benthacher/pedal/pedal.kicad_pcb

## KiCad design pedal.kicad_pcb (2026-10-10)

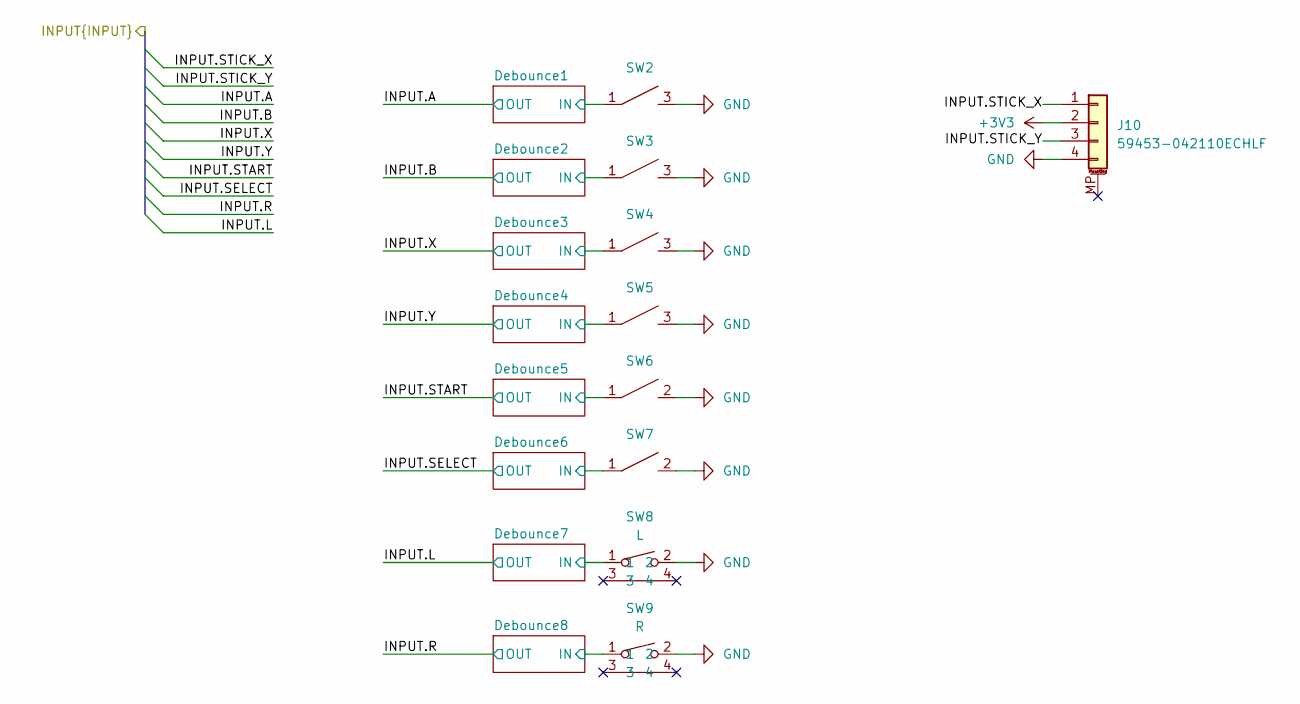
[picture p1: schematic input.kicad_sch]

Parts:
J10: 59453-042110ECHLF; AMPHENOL_59453-042110ECHLF; LCSC C3169529
SW2: A; SW-SMD_4P-L4.5-W4.5-P3.50-LS4.8; MPN TL3315NF100Q; LCSC Part C173769
SW3: B; SW-SMD_4P-L4.5-W4.5-P3.50-LS4.8; MPN TL3315NF100Q; LCSC Part C173769
SW4: X; SW-SMD_4P-L4.5-W4.5-P3.50-LS4.8; MPN TL3315NF100Q; LCSC Part C173769
SW5: Y; SW-SMD_4P-L4.5-W4.5-P3.50-LS4.8; MPN TL3315NF100Q; LCSC Part C173769
SW6: START; SW-SMD_L3.9-W3.0-P4.45; MPN TS-1088-AR02016; LCSC Part C720477
SW7: SELECT; SW-SMD_L3.9-W3.0-P4.45; MPN TS-1088-AR02016; LCSC Part C720477
SW8: L; SW-SMD_L4.7-W3.5-P3.35-EH; MPN TS-24CA-S26; LCSC Part C42420265
SW9: R; SW-SMD_L4.7-W3.5-P3.35-EH; MPN TS-24CA-S26; LCSC Part C42420265

Connections:
+3V3: J10.2; also elsewhere on the board
/Input/Debounce1/IN: SW2.1, SW2.2; also elsewhere on the board
/Input/Debounce2/IN: SW3.1, SW3.2; also elsewhere on the board
/Input/Debounce3/IN: SW4.1, SW4.2; also elsewhere on the board
/Input/Debounce4/IN: SW5.1, SW5.2; also elsewhere on the board
/Input/Debounce5/IN: SW6.1; also elsewhere on the board
/Input/Debounce6/IN: SW7.1; also elsewhere on the board
/Input/Debounce7/IN: SW8.1; also elsewhere on the board
/Input/Debounce8/IN: SW9.1; also elsewhere on the board
/Input/INPUT.STICK_X: J10.1; also elsewhere on the board
/Input/INPUT.STICK_Y: J10.3; also elsewhere on the board
GND: J10.4, SW2.3, SW2.4, SW3.3, SW3.4, SW4.3, SW4.4, SW5.3, SW5.4, SW6.2, SW7.2, SW8.2, SW9.2; also elsewhere on the board

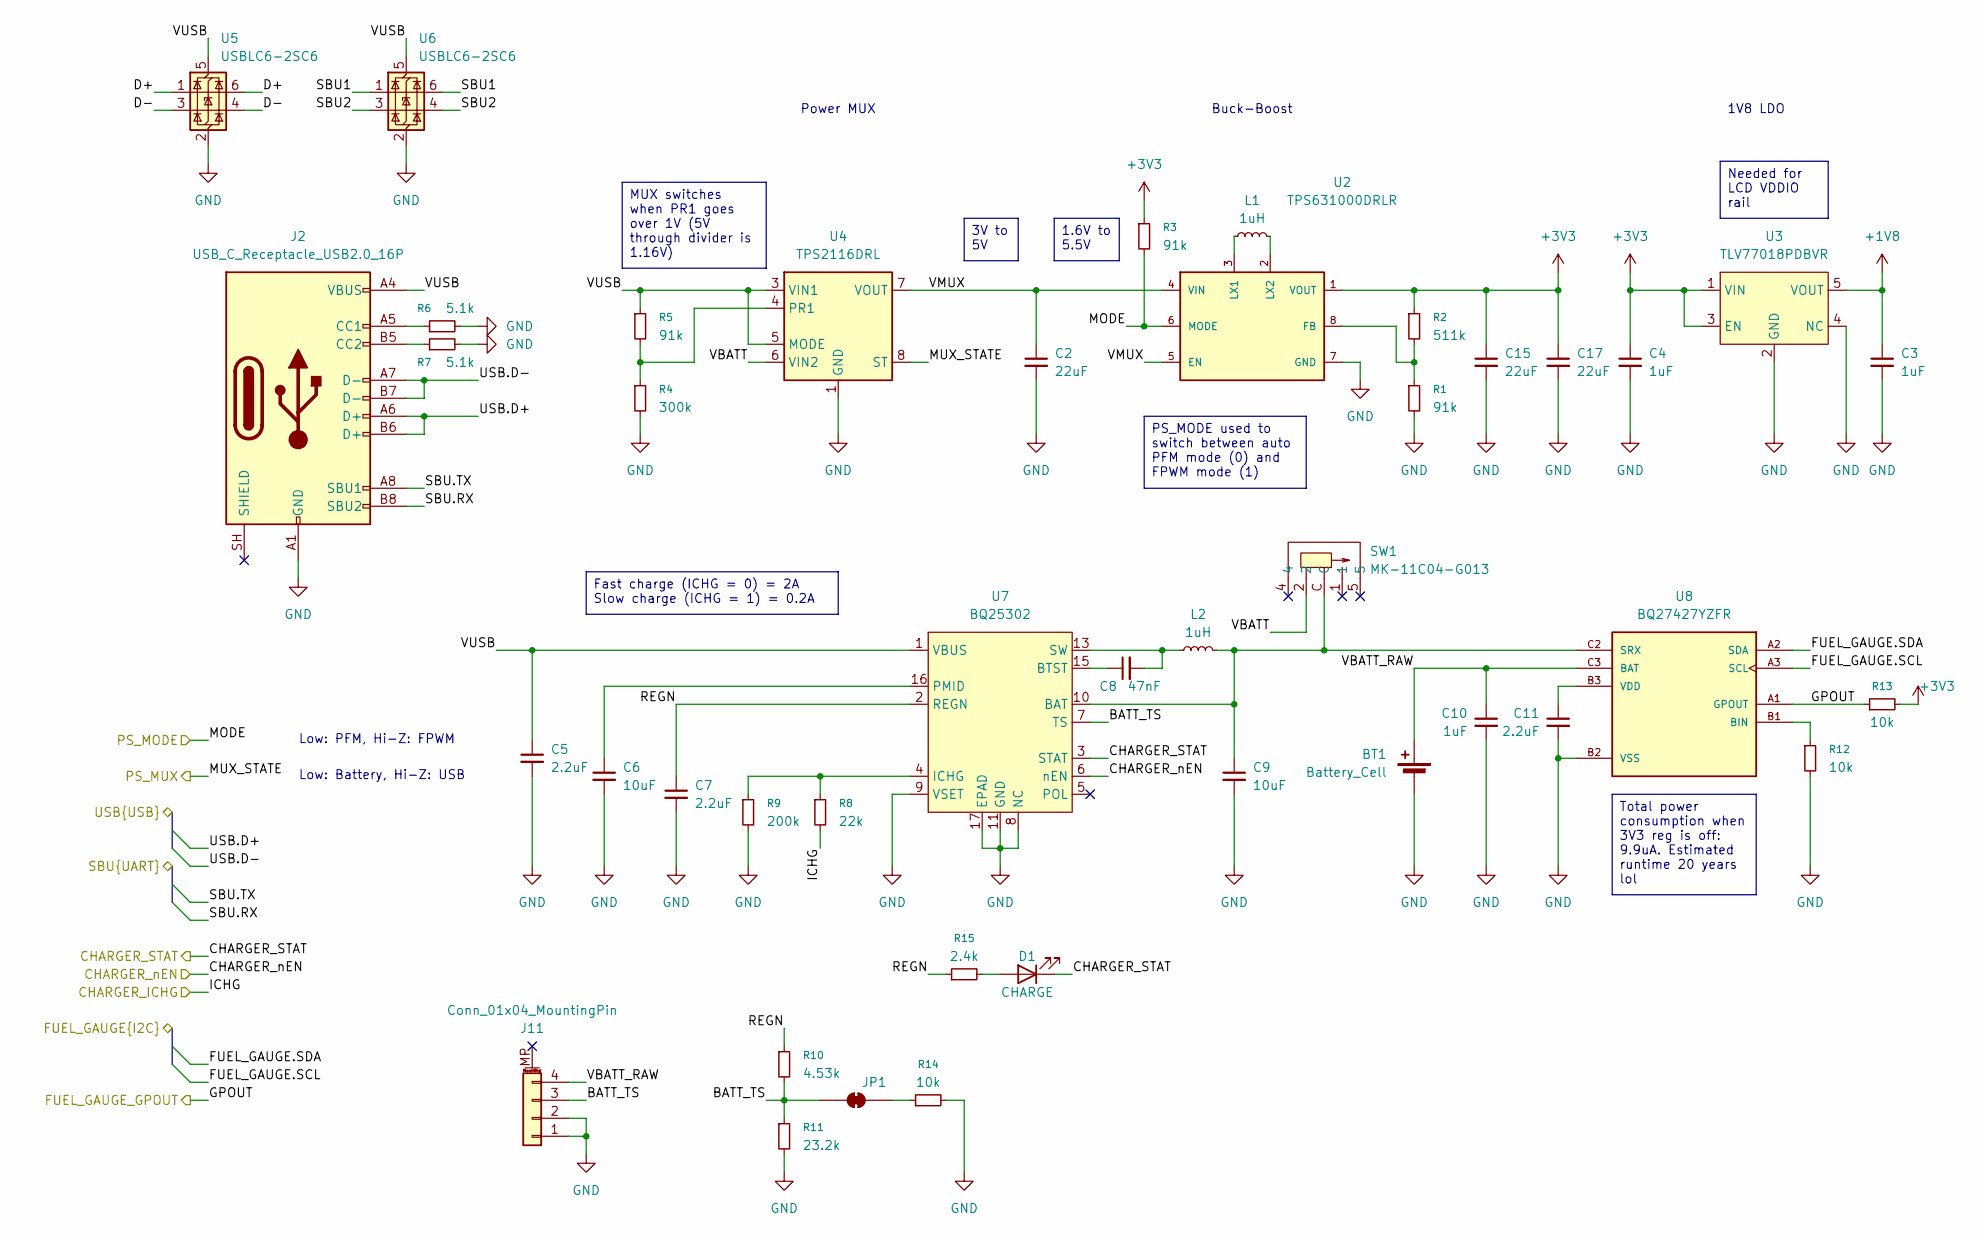
[picture p2: schematic power_path.kicad_sch]

Parts:
BT1: Battery_Cell
C2, C15, C17: 22uF; C_0805_2012Metric; Voltage 25V; LCSC C45783
C3: 1uF; C_0402_1005Metric; LCSC C52923
C4, C10: 1uF; C_0402_1005Metric; voltage 25; LCSC C52923
C5, C7, C11: 2.2uF; C_0603_1608Metric; Voltage 16; LCSC C23630
C6, C9: 10uF; C_0603_1608Metric; Voltage 25; LCSC C96446
C8: 47nF; C_0603_1608Metric; Voltage 50; LCSC C1622
D1: CHARGE; LED_0402_1005Metric; LCSC C5123495
J2: USB_C_Receptacle_USB2.0_16P; USB_C_Receptacle_HRO_TYPE-C-31-M-12; LCSC C165948
J11: Conn_01x04_MountingPin; CONN-SMD_4P-P1.00_2121340004
JP1: SolderJumper-2_P1.3mm_Bridged2Bar_RoundedPad1.0x1.5mm
L1, L2: 1uH; L_1008_2520Metric; LCSC C882955
R1, R3, R5: 91k; R_0402_1005Metric; LCSC C327323
R2: 511k; R_0402_1005Metric; LCSC C64042
R4: 300k; R_0402_1005Metric; LCSC C25774
R6, R7: 5.1k; R_0402_1005Metric; LCSC C25905
R8: 22k; R_0402_1005Metric; LCSC C25768
R9: 200k; R_0402_1005Metric; LCSC C25764
R10: 4.53k; R_0402_1005Metric; LCSC C79537
R11: 23.2k; R_0402_1005Metric; LCSC C25873
R12, R13, R14: 10k; R_0402_1005Metric; LCSC C25744
R15: 2.4k; R_0402_1005Metric; LCSC C25882
SW1: MK-11C04-G013; SW-SMD_MK-11C04-G013; MPN MK-11C04-G013; LCSC Part C778185
U2: TPS631000DRLR; SOT50P160X60-8N; PARTREV B; DigiKey_Part_Number 296-TPS631000DRLRCT-ND
U3: TLV77018PDBVR; SOT-23-5
U4: TPS2116DRL; SOT-583-8
U5, U6: USBLC6-2SC6; SOT-23-6; LCSC C5180249
U7: BQ25302; WQFN-16-1EP_3x3mm_P0.5mm_EP1.68x1.68mm_ThermalVias; LCSC C2761617
U8: BQ27427YZFR; IC_BQ27427YZFR; PARTREV December 2022; DigiKey_Part_Number 296-BQ27427YZFRCT-ND

Connections:
+1V8: C3.1, U3.5 (VOUT); also elsewhere on the board
+3V3: C4.1, C15.1, C17.1, R2.1, R3.1, R13.2, U2.1 (VOUT), U3.1 (VIN), U3.3 (EN); also elsewhere on the board
/Power path/BATT_TS: J11.3, JP1.1 (A), R10.2, R11.1, U7.7 (TS)
/Power path/CHARGER_STAT: D1.1 (K), U7.3 (STAT); also elsewhere on the board
/Power path/CHARGER_nEN: U7.6 (nEN); also elsewhere on the board
/Power path/D+: U5.1 (I/O1), U5.6 (I/O1)
/Power path/D-: U5.3 (I/O2), U5.4 (I/O2)
/Power path/FUEL_GAUGE.SCL: U8.A3 (SCL); also elsewhere on the board
/Power path/FUEL_GAUGE.SDA: U8.A2 (SDA); also elsewhere on the board
/Power path/GPOUT: R13.1, U8.A1 (GPOUT); also elsewhere on the board
/Power path/ICHG: R8.2; also elsewhere on the board
/Power path/MODE: R3.2, U2.6 (MODE); also elsewhere on the board
/Power path/MUX_STATE: U4.8 (ST); also elsewhere on the board
/Power path/REGN: C7.1, R10.1, R15.1, U7.2 (REGN)
/Power path/SBU1: U6.1 (I/O1), U6.6 (I/O1)
/Power path/SBU2: U6.3 (I/O2), U6.4 (I/O2)
/Power path/SBU.RX: J2.B8 (SBU2); also elsewhere on the board
/Power path/SBU.TX: J2.A8 (SBU1); also elsewhere on the board
/Power path/USB.D+: J2.A6 (D+), J2.B6 (D+); also elsewhere on the board
/Power path/USB.D-: J2.A7 (D-), J2.B7 (D-); also elsewhere on the board
/Power path/VBATT: SW1.2, U4.6 (VIN2)
/Power path/VBATT_RAW: BT1.1 (+), C10.1, J11.4, U8.C3 (BAT)
/Power path/VMUX: C2.1, U2.4 (VIN), U2.5 (EN), U4.2 (VOUT), U4.7 (VOUT)
/Power path/VUSB: C5.1, J2.A4 (VBUS), J2.A9 (VBUS), J2.B4 (VBUS), J2.B9 (VBUS), R5.1, U4.3 (VIN1), U4.5 (MODE), U5.5 (VBUS), U6.5 (VBUS), U7.1 (VBUS)
GND: BT1.2 (-), C2.2, C3.2, C4.2, C5.2, C6.2, C7.2, C9.2, C10.2, C11.2, C15.2, C17.2, J2.A1 (GND), J2.A12 (GND), J2.B1 (GND), J2.B12 (GND), J11.1, J11.2, R1.2, R4.2, R6.2, R7.2, R9.2, R11.2, R12.2, R14.2, U2.7 (GND), U3.2 (GND), U3.4 (NC), U4.1 (GND), U5.2 (GND), U6.2 (GND), U7.8 (NC), U7.9 (VSET), U7.11 (GND), U7.12 (GND), U7.17 (EPAD), U8.B2 (VSS), U8.C1 (VSS); also elsewhere on the board
unnamed: C8.2, L2.1, U7.13 (SW), U7.14 (SW)
unnamed: D1.2 (A), R15.2
unnamed: J2.A5 (CC1), R6.1
unnamed: J2.B5 (CC2), R7.1
unnamed: JP1.2 (B), R14.1
unnamed: R1.1, R2.2, U2.8 (FB)
unnamed: L1.1, U2.3 (LX1)
unnamed: L1.2, U2.2 (LX2)
unnamed: R4.1, R5.2, U4.4 (PR1)
unnamed: C9.1, L2.2, SW1.C, U7.10 (BAT), U8.C2 (SRX)
unnamed: C8.1, U7.15 (BTST)
unnamed: R8.1, R9.1, U7.4 (ICHG)
unnamed: C6.1, U7.16 (PMID)
unnamed: R12.1, U8.B1 (BIN)
unnamed: C11.1, U8.B3 (VDD)

Notes on the sheet:
Low: Battery, Hi-Z: USB
1V8 LDO
Buck-Boost
Low: PFM, Hi-Z: FPWM
Power MUX
Total power consumption when 3V3 reg is off: 9.9uA. Estimated runtime 20 years lol
3V to 5V
Needed for LCD VDDIO rail
MUX switches when PR1 goes over 1V (5V through divider is 1.16V)
1.6V to 5.5V
Fast charge (ICHG = 0) = 2A Slow charge (ICHG = 1) = 0.2A
PS_MODE used to switch between auto PFM mode (0) and FPWM mode (1)

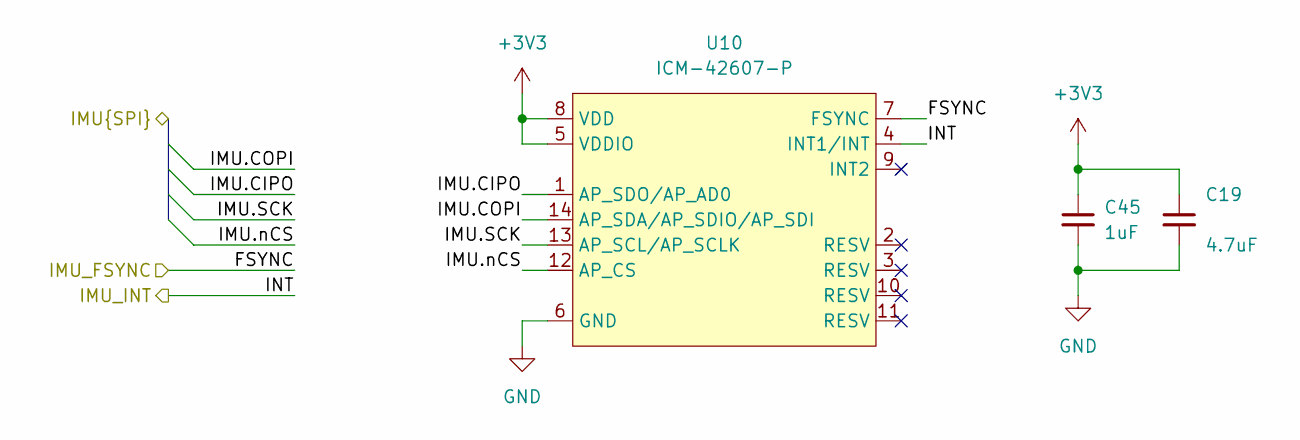
[picture p3: schematic imu.kicad_sch]

Parts:
C19: 4.7uF; C_0402_1005Metric; LCSC C23733
C45: 1uF; C_0402_1005Metric; voltage 25; LCSC C52923
U10: ICM-42607-P; LGA-14_L3.0-W2.5-P0.50-TL_QMI8658A; MPN ICM-42607-P; LCSC Part C5129967

Connections:
+3V3: C19.1, C45.1, U10.5 (VDDIO), U10.8 (VDD); also elsewhere on the board
/IMU/FSYNC: U10.7 (FSYNC); also elsewhere on the board
/IMU/IMU.CIPO: U10.1 (AP_SDO/AP_AD0); also elsewhere on the board
/IMU/IMU.COPI: U10.14 (AP_SDA/AP_SDIO/AP_SDI); also elsewhere on the board
/IMU/IMU.SCK: U10.13 (AP_SCL/AP_SCLK); also elsewhere on the board
/IMU/IMU.nCS: U10.12 (AP_CS); also elsewhere on the board
/IMU/INT: U10.4 (INT1/INT); also elsewhere on the board
GND: C19.2, C45.2, U10.6 (GND); also elsewhere on the board

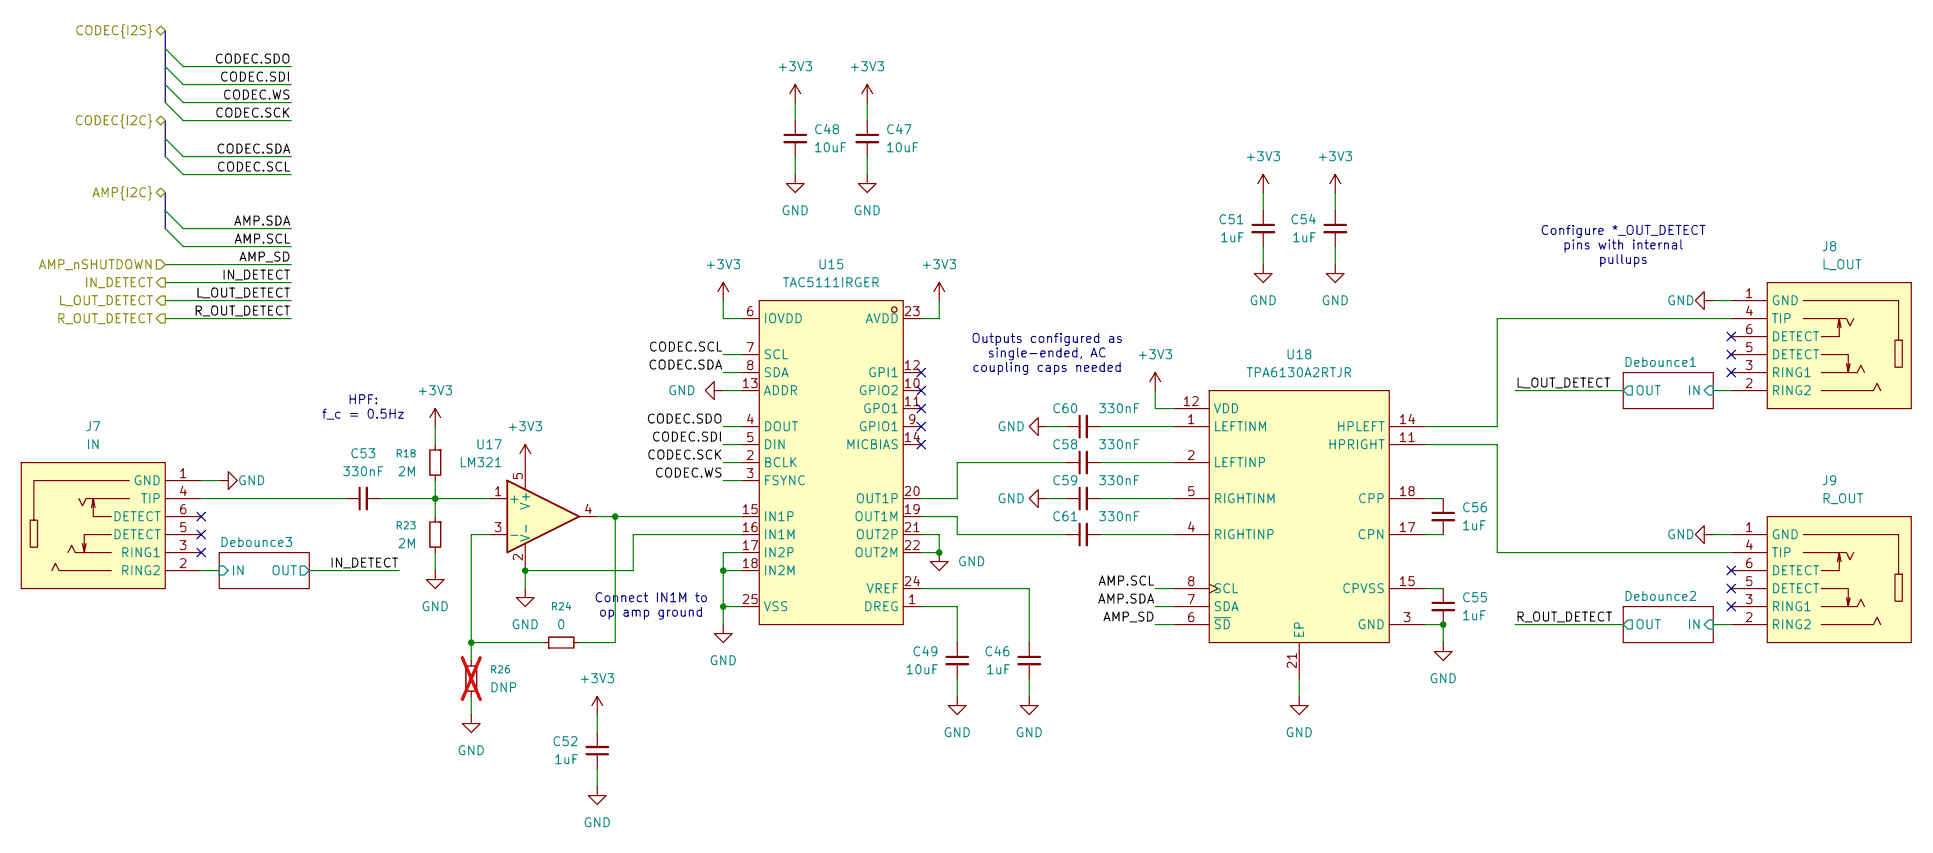
[picture p4: schematic codec.kicad_sch]

Parts:
C46, C51, C52, C54, C55, C56: 1uF; C_0402_1005Metric; voltage 25; LCSC C52923
C47, C48, C49: 10uF; C_0603_1608Metric; Voltage 25; LCSC C96446
C53, C58, C59, C60, C61: 330nF; C_1206_3216Metric; Voltage 25; LCSC C3837965
J7: IN; AUDIO-SMD_PJ-342-141; MPN PJ-342 141; LCSC Part C7507452
J8: L_OUT; AUDIO-SMD_PJ-342-141; MPN PJ-342 141; LCSC Part C7507452
J9: R_OUT; AUDIO-SMD_PJ-342-141; MPN PJ-342 141; LCSC Part C7507452
R18, R23: 2M; R_0603_1608Metric; LCSC C22976
R24: 0; R_0402_1005Metric; LCSC C17168
R26: DNP; R_0402_1005Metric; not fitted
U15: TAC5111IRGER; VQFN-24_L4.0-W4.0-P0.50-BL-EP2.1_1; MPN TAC5111IRGER; LCSC Part C45335502
U17: LM321; SC-70-5_L2.1-W1.3-P0.65-LS2.1-BR
U18: TPA6130A2RTJR; QFN-20_L4.0-W4.0-P0.5-TL-EP; MPN TPA6130A2RTJR; LCSC Part C130046

Connections:
+3V3: C47.1, C48.1, C51.1, C52.2, C54.1, R18.1, U15.6 (IOVDD), U15.23 (AVDD), U17.5 (V+), U18.12 (VDD), U18.20 (VDD); also elsewhere on the board
/Codec/AMP.SCL: U18.8 (SCL); also elsewhere on the board
/Codec/AMP.SDA: U18.7 (SDA); also elsewhere on the board
/Codec/AMP_SD: U18.6 (~SD); also elsewhere on the board
/Codec/CODEC.SCK: U15.2 (BCLK); also elsewhere on the board
/Codec/CODEC.SCL: U15.7 (SCL); also elsewhere on the board
/Codec/CODEC.SDA: U15.8 (SDA); also elsewhere on the board
/Codec/CODEC.SDI: U15.5 (DIN); also elsewhere on the board
/Codec/CODEC.SDO: U15.4 (DOUT); also elsewhere on the board
/Codec/CODEC.WS: U15.3 (FSYNC); also elsewhere on the board
/Codec/Debounce1/IN: J8.2 (RING2); also elsewhere on the board
/Codec/Debounce2/IN: J9.2 (RING2); also elsewhere on the board
/Codec/Debounce3/IN: J7.2 (RING2); also elsewhere on the board
CPVSS: C55.1, U18.15 (CPVSS), U18.16 (CPVSS)
GND: C46.2, C47.2, C48.2, C49.2, C51.2, C52.1, C54.2, C55.2, C59.1, C60.1, J7.1 (GND), J8.1 (GND), J9.1 (GND), R23.2, R26.1, U15.13 (ADDR), U15.16 (IN1M), U15.17 (IN2P), U15.18 (IN2M), U15.21 (OUT2P), U15.22 (OUT2M), U15.25 (VSS), U15.A1 (VSS), U15.A2 (VSS), U15.A3 (VSS), U15.A4 (VSS), U17.2 (V-), U18.3 (GND), U18.9 (GND), U18.10 (GND), U18.13 (GND), U18.19 (GND), U18.21 (EP); also elsewhere on the board
unnamed: C53.1, J7.4 (TIP)
unnamed: J8.4 (TIP), U18.14 (HPLEFT)
unnamed: J9.4 (TIP), U18.11 (HPRIGHT)
unnamed: C49.1, U15.1 (DREG)
unnamed: R24.2, U15.15 (IN1P), U17.4
unnamed: C61.1, U15.19 (OUT1M)
unnamed: C58.1, U15.20 (OUT1P)
unnamed: C46.1, U15.24 (VREF)
unnamed: C53.2, R18.2, R23.1, U17.1 (+)
unnamed: R24.1, R26.2, U17.3 (-)
unnamed: C56.2, U18.17 (CPN)
unnamed: C56.1, U18.18 (CPP)
unnamed: C60.2, U18.1 (LEFTINM)
unnamed: C58.2, U18.2 (LEFTINP)
unnamed: C59.2, U18.5 (RIGHTINM)
unnamed: C61.2, U18.4 (RIGHTINP)

Notes on the sheet:
Connect IN1M to op amp ground
Configure *_OUT_DETECT pins with internal pullups
HPF: f_c = 0.5Hz
Outputs configured as single-ended, AC coupling caps needed

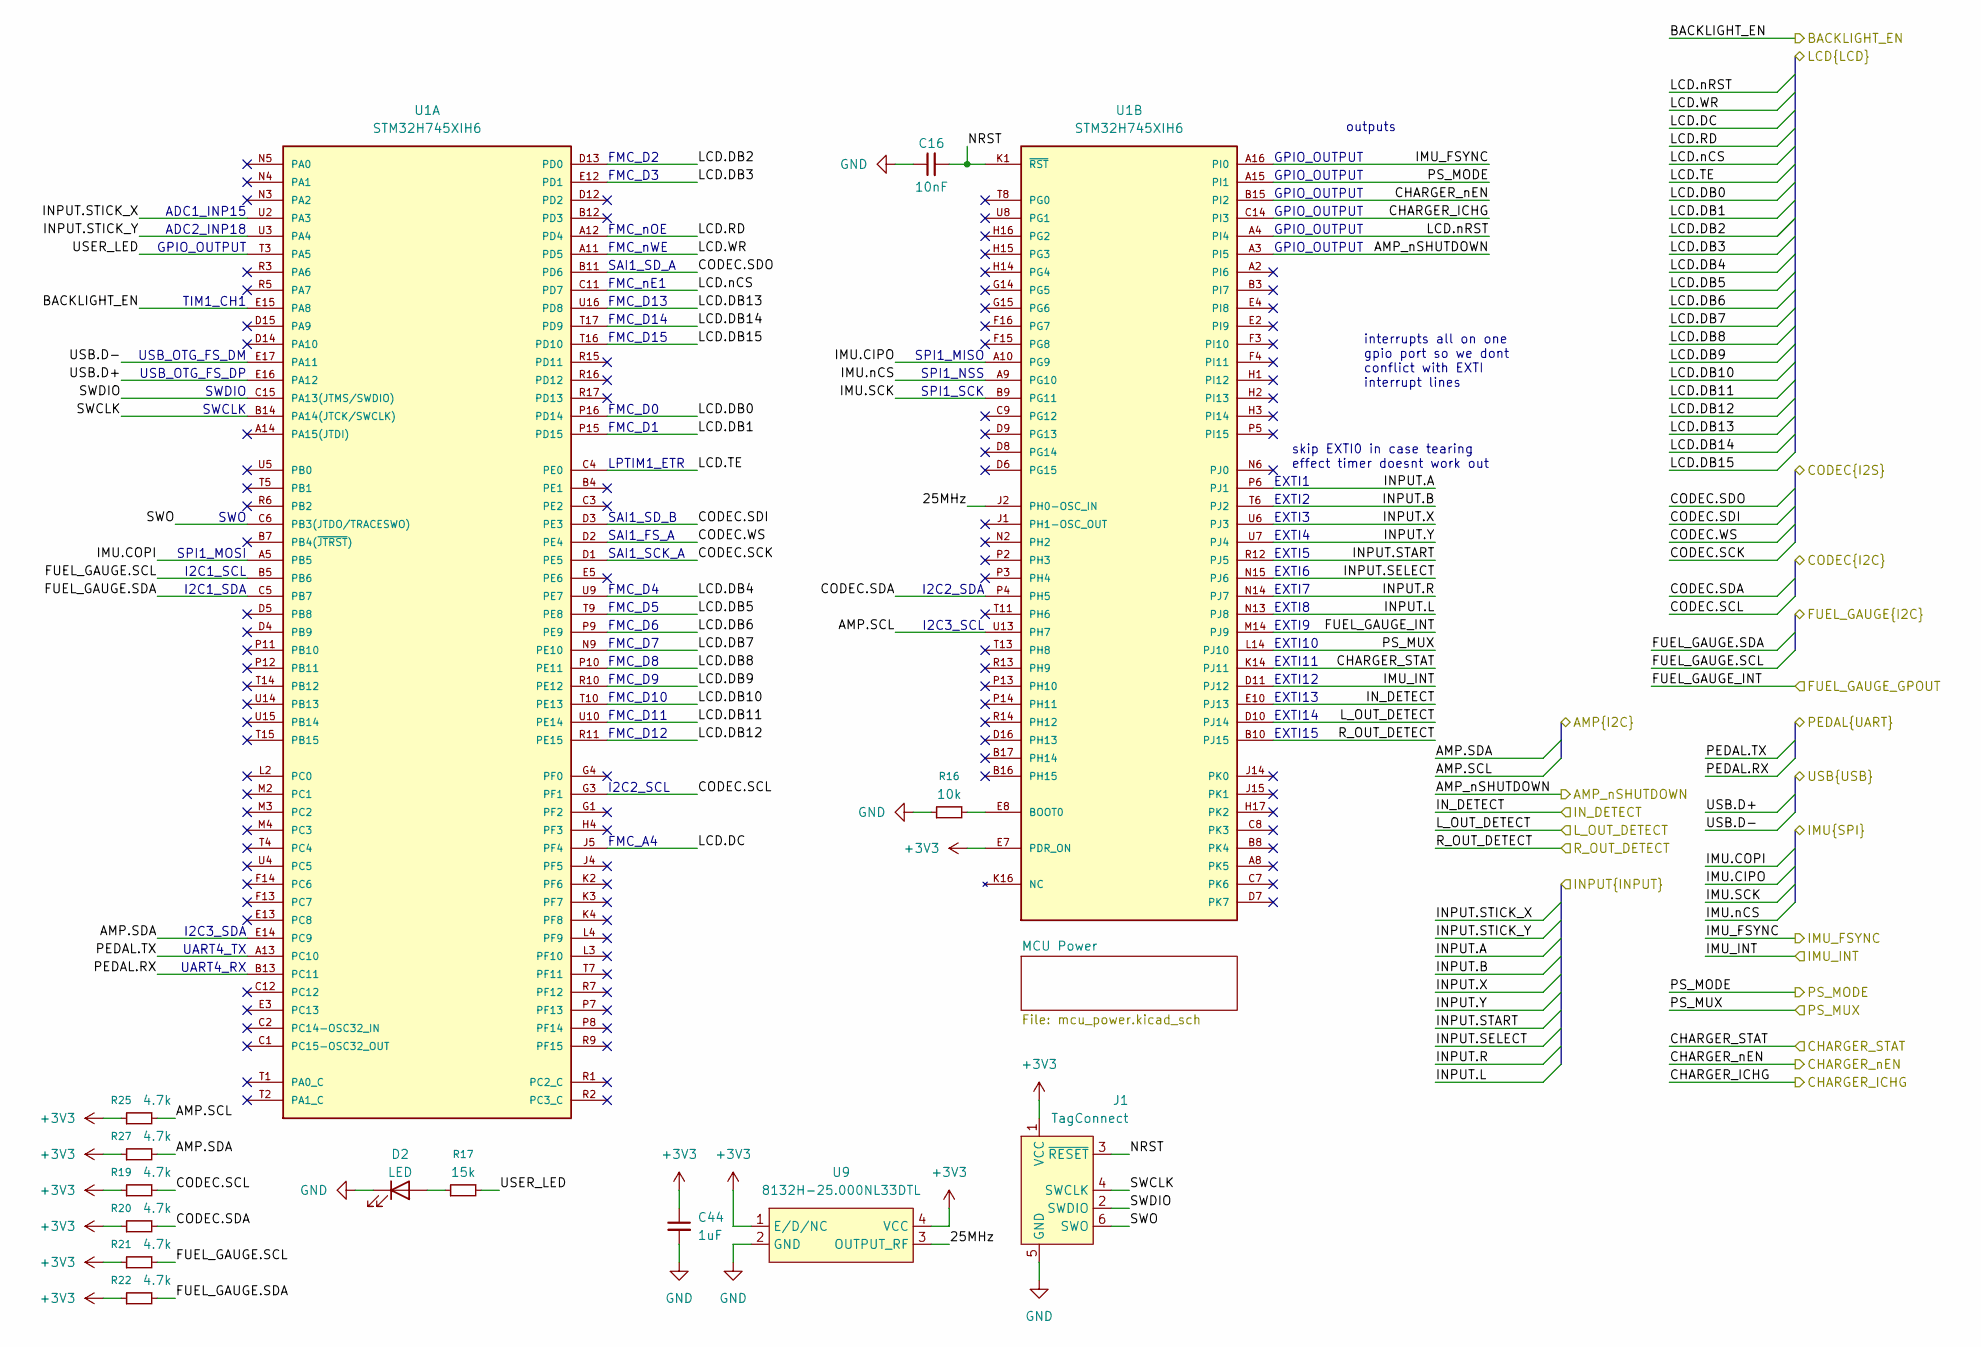
[picture p5: schematic microcontroller.kicad_sch]

Parts:
C16: 10nF; C_0402_1005Metric; Voltage 50V; LCSC C15195
C44: 1uF; C_0402_1005Metric; voltage 25; LCSC C52923
D2: LED; LED_0402_1005Metric; LCSC C965793
J1: TagConnect; Tag-Connect_TC2030-IDC-NL_2x03_P1.27mm_Vertical
R16: 10k; R_0402_1005Metric; LCSC C25744
R17: 15k; R_0402_1005Metric; LCSC C25756
R19, R20, R21, R22, R25, R27: 4.7k; R_0402_1005Metric; LCSC C25900
U1: STM32H745XIH6; BGA265C80P17X17_1400X1400X120; PARTREV 3; LCSC C1338373
U9: 8132H-25.000NL33DTL; OSC-SMD_4P-L3.2-W2.5-BL; MPN 8132H-25.000NL33DTL; LCSC Part C46598430

Connections:
+3V3: C44.1, J1.1 (VCC), R19.1, R20.1, R21.1, R22.1, R25.1, R27.1, U1.E7 (PDR_ON), U9.1 (E/D/NC), U9.4 (VCC); also elsewhere on the board
/Codec/AMP.SCL: R25.2, U1.U13 (PH7); also elsewhere on the board
/Codec/AMP.SDA: R27.2, U1.E14 (PC9); also elsewhere on the board
/Codec/AMP_SD: U1.A3 (PI5); also elsewhere on the board
/Codec/CODEC.SCK: U1.D1 (PE5); also elsewhere on the board
/Codec/CODEC.SCL: R19.2, U1.G3 (PF1); also elsewhere on the board
/Codec/CODEC.SDA: R20.2, U1.P4 (PH5); also elsewhere on the board
/Codec/CODEC.SDI: U1.D3 (PE3); also elsewhere on the board
/Codec/CODEC.SDO: U1.B11 (PD6); also elsewhere on the board
/Codec/CODEC.WS: U1.D2 (PE4); also elsewhere on the board
/Codec/IN_DETECT: U1.E10 (PJ13); also elsewhere on the board
/Codec/L_OUT_DETECT: U1.D10 (PJ14); also elsewhere on the board
/Codec/R_OUT_DETECT: U1.B10 (PJ15); also elsewhere on the board
/IMU/FSYNC: U1.A16 (PI0); also elsewhere on the board
/IMU/IMU.CIPO: U1.A10 (PG9); also elsewhere on the board
/IMU/IMU.COPI: U1.A5 (PB5); also elsewhere on the board
/IMU/IMU.SCK: U1.B9 (PG11); also elsewhere on the board
/IMU/IMU.nCS: U1.A9 (PG10); also elsewhere on the board
/IMU/INT: U1.D11 (PJ12); also elsewhere on the board
/Input/INPUT.A: U1.P6 (PJ1); also elsewhere on the board
/Input/INPUT.B: U1.T6 (PJ2); also elsewhere on the board
/Input/INPUT.L: U1.N13 (PJ8); also elsewhere on the board
/Input/INPUT.R: U1.N14 (PJ7); also elsewhere on the board
/Input/INPUT.SELECT: U1.N15 (PJ6); also elsewhere on the board
/Input/INPUT.START: U1.R12 (PJ5); also elsewhere on the board
/Input/INPUT.STICK_X: U1.U2 (PA3); also elsewhere on the board
/Input/INPUT.STICK_Y: U1.U3 (PA4); also elsewhere on the board
/Input/INPUT.X: U1.U6 (PJ3); also elsewhere on the board
/Input/INPUT.Y: U1.U7 (PJ4); also elsewhere on the board
/Power path/CHARGER_STAT: U1.K14 (PJ11); also elsewhere on the board
/Power path/CHARGER_nEN: U1.B15 (PI2); also elsewhere on the board
/Power path/FUEL_GAUGE.SCL: R21.2, U1.B5 (PB6); also elsewhere on the board
/Power path/FUEL_GAUGE.SDA: R22.2, U1.C5 (PB7); also elsewhere on the board
/Power path/GPOUT: U1.M14 (PJ9); also elsewhere on the board
/Power path/ICHG: U1.C14 (PI3); also elsewhere on the board
/Power path/MODE: U1.A15 (PI1); also elsewhere on the board
/Power path/MUX_STATE: U1.L14 (PJ10); also elsewhere on the board
/Power path/SBU.RX: U1.B13 (PC11); also elsewhere on the board
/Power path/SBU.TX: U1.A13 (PC10); also elsewhere on the board
/Power path/USB.D+: U1.E16 (PA12); also elsewhere on the board
/Power path/USB.D-: U1.E17 (PA11); also elsewhere on the board
/display/LCD.DB0: U1.P16 (PD14); also elsewhere on the board
/display/LCD.DB1: U1.P15 (PD15); also elsewhere on the board
/display/LCD.DB2: U1.D13 (PD0); also elsewhere on the board
/display/LCD.DB3: U1.E12 (PD1); also elsewhere on the board
/display/LCD.DB4: U1.U9 (PE7); also elsewhere on the board
/display/LCD.DB5: U1.T9 (PE8); also elsewhere on the board
/display/LCD.DB6: U1.P9 (PE9); also elsewhere on the board
/display/LCD.DB7: U1.N9 (PE10); also elsewhere on the board
/display/LCD.DB8: U1.P10 (PE11); also elsewhere on the board
/display/LCD.DB9: U1.R10 (PE12); also elsewhere on the board
/display/LCD.DB10: U1.T10 (PE13); also elsewhere on the board
/display/LCD.DB11: U1.U10 (PE14); also elsewhere on the board
/display/LCD.DB12: U1.R11 (PE15); also elsewhere on the board
/display/LCD.DB13: U1.U16 (PD8); also elsewhere on the board
/display/LCD.DB14: U1.T17 (PD9); also elsewhere on the board
/display/LCD.DB15: U1.T16 (PD10); also elsewhere on the board
/display/LCD.DC: U1.J5 (PF4); also elsewhere on the board
/display/LCD.RD: U1.A12 (PD4); also elsewhere on the board
/display/LCD.TE: U1.C4 (PE0); also elsewhere on the board
/display/LCD.WR: U1.A11 (PD5); also elsewhere on the board
/display/LCD.nCS: U1.C11 (PD7); also elsewhere on the board
/display/LCD.nRST: U1.A4 (PI4); also elsewhere on the board
/microcontroller/25MHz: U1.J2 (PH0-OSC_IN), U9.3 (OUTPUT_RF)
/microcontroller/BACKLIGHT_EN: U1.E15 (PA8); also elsewhere on the board
/microcontroller/NRST: C16.2, J1.3 (~RESET), U1.K1 (~RST)
/microcontroller/SWCLK: J1.4 (SWCLK), U1.B14 (PA14(JTCK/SWCLK))
/microcontroller/SWDIO: J1.2 (SWDIO), U1.C15 (PA13(JTMS/SWDIO))
/microcontroller/SWO: J1.6 (SWO), U1.C6 (PB3(JTDO/TRACESWO))
/microcontroller/USER_LED: R17.2, U1.T3 (PA5)
GND: C16.1, C44.2, D2.1 (K), J1.5 (GND), R16.1, U9.2 (GND); also elsewhere on the board
unnamed: D2.2 (A), R17.1
unnamed: R16.2, U1.E8 (BOOT0)

Notes on the sheet:
SAI1_SD_B
LPTIM1_ETR
SPI1_SCK
outputs
EXTI5
FMC_D7
EXTI9
EXTI7
ADC2_INP18
SPI1_MOSI
FMC_D6
I2C1_SCL
FMC_D9
I2C2_SCL
I2C2_SDA
FMC_nE1
FMC_D0
EXTI3
EXTI4
FMC_D5
EXTI6
SAI1_SD_A
FMC_nOE
I2C1_SDA
FMC_D10
FMC_nWE
GPIO_OUTPUT
EXTI13
EXTI10
EXTI15
ADC1_INP15
FMC_D12
SWO
FMC_D13
SWDIO
FMC_A4
FMC_D4
SAI1_SCK_A
FMC_D14
EXTI11
EXTI2
USB_OTG_FS_DM
EXTI8
FMC_D3
EXTI14
SAI1_FS_A
EXTI1
FMC_D15
SWCLK
FMC_D11
FMC_D8
TIM1_CH1
skip EXTI0 in case tearing effect timer doesnt work out
EXTI12
SPI1_NSS
I2C3_SDA
I2C3_SCL
SPI1_MISO
UART4_TX
FMC_D1
FMC_D2
UART4_RX
USB_OTG_FS_DP
interrupts all on one gpio port so we dont conflict with EXTI interrupt lines

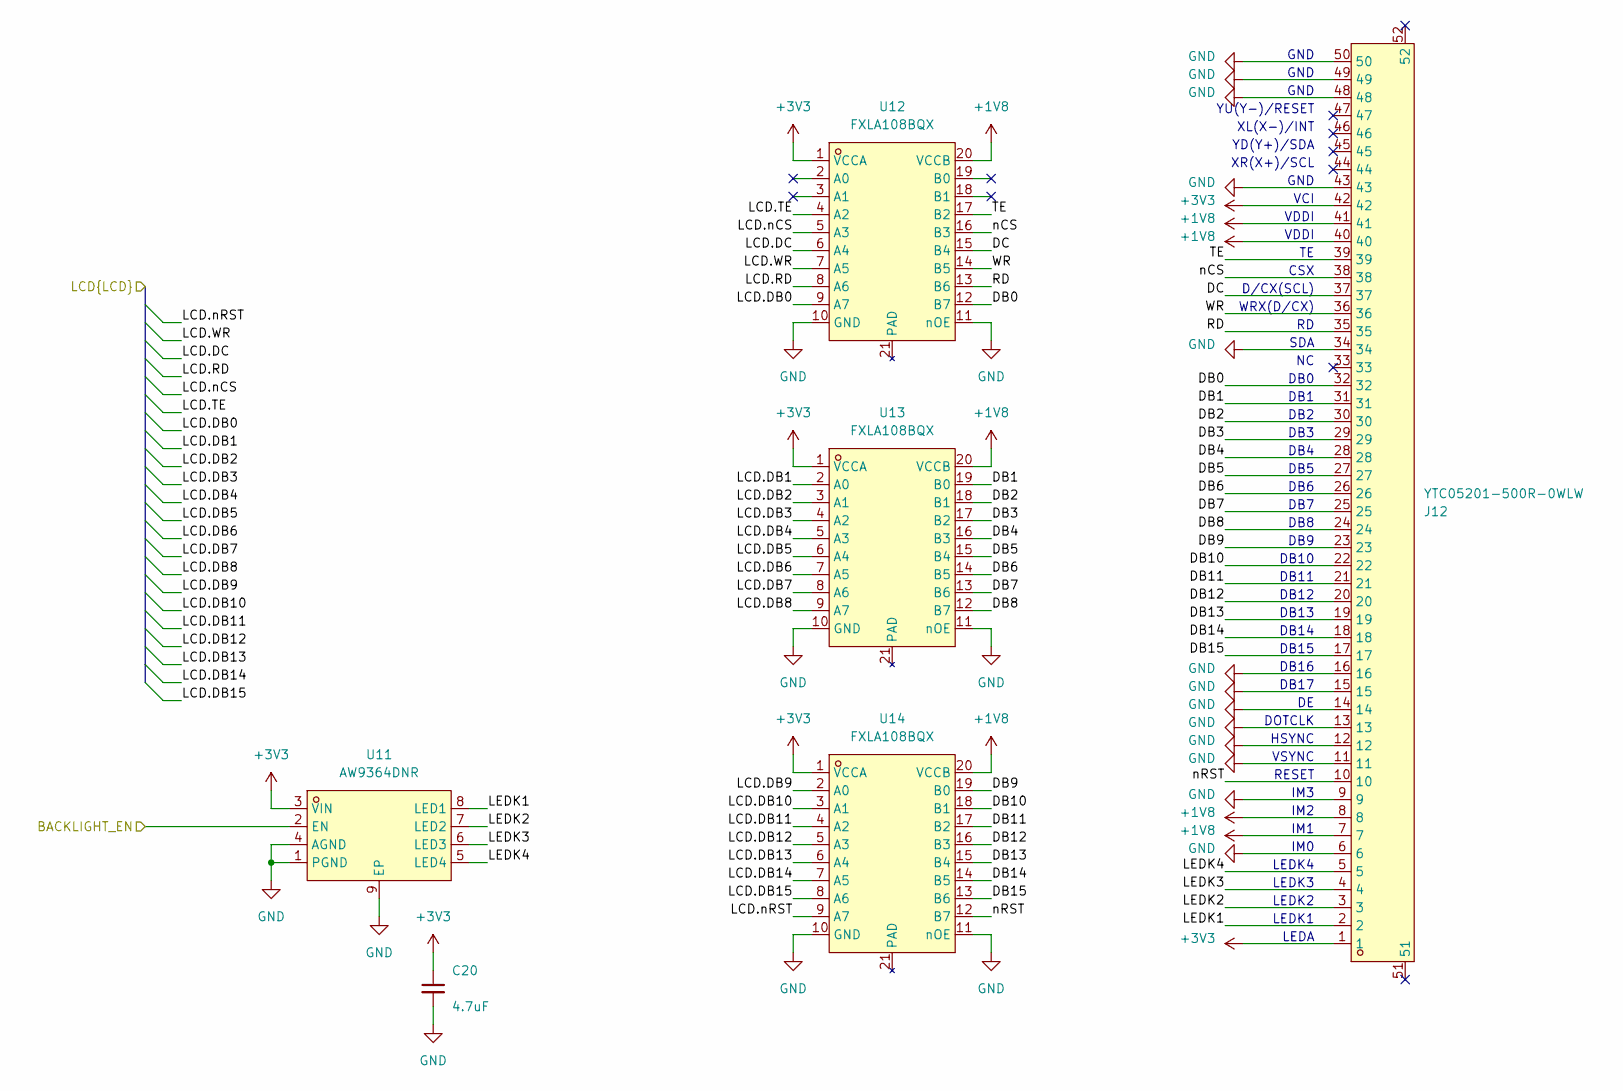
[picture p6: schematic display.kicad_sch]

Parts:
C20: 4.7uF; C_0402_1005Metric; LCSC C23733
J12: YTC05201-500R-0WLW; FPC-SMD_50P-P0.50_YTC05201-500R-0WLW; MPN YTC05201-500R-0WLW; LCSC Part C19673900
U11: AW9364DNR; DFN-8_L2.0-W2.0-P0.50-BL-EP-1; MPN AW9364DNR; LCSC Part C401007
U12, U13, U14: FXLA108BQX; DHVQFN-20_L4.5-W2.5-P0.50-BL-EP; MPN FXLA108BQX; LCSC Part C603076

Connections:
+1V8: J12.7, J12.8, J12.40, J12.41, U12.20 (VCCB), U13.20 (VCCB), U14.20 (VCCB); also elsewhere on the board
+3V3: C20.1, J12.1, J12.42, U11.3 (VIN), U12.1 (VCCA), U13.1 (VCCA), U14.1 (VCCA); also elsewhere on the board
/display/DB0: J12.32, U12.12 (B7)
/display/DB1: J12.31, U13.19 (B0)
/display/DB2: J12.30, U13.18 (B1)
/display/DB3: J12.29, U13.17 (B2)
/display/DB4: J12.28, U13.16 (B3)
/display/DB5: J12.27, U13.15 (B4)
/display/DB6: J12.26, U13.14 (B5)
/display/DB7: J12.25, U13.13 (B6)
/display/DB8: J12.24, U13.12 (B7)
/display/DB9: J12.23, U14.19 (B0)
/display/DB10: J12.22, U14.18 (B1)
/display/DB11: J12.21, U14.17 (B2)
/display/DB12: J12.20, U14.16 (B3)
/display/DB13: J12.19, U14.15 (B4)
/display/DB14: J12.18, U14.14 (B5)
/display/DB15: J12.17, U14.13 (B6)
/display/DC: J12.37, U12.15 (B4)
/display/LCD.DB0: U12.9 (A7); also elsewhere on the board
/display/LCD.DB1: U13.2 (A0); also elsewhere on the board
/display/LCD.DB2: U13.3 (A1); also elsewhere on the board
/display/LCD.DB3: U13.4 (A2); also elsewhere on the board
/display/LCD.DB4: U13.5 (A3); also elsewhere on the board
/display/LCD.DB5: U13.6 (A4); also elsewhere on the board
/display/LCD.DB6: U13.7 (A5); also elsewhere on the board
/display/LCD.DB7: U13.8 (A6); also elsewhere on the board
/display/LCD.DB8: U13.9 (A7); also elsewhere on the board
/display/LCD.DB9: U14.2 (A0); also elsewhere on the board
/display/LCD.DB10: U14.3 (A1); also elsewhere on the board
/display/LCD.DB11: U14.4 (A2); also elsewhere on the board
/display/LCD.DB12: U14.5 (A3); also elsewhere on the board
/display/LCD.DB13: U14.6 (A4); also elsewhere on the board
/display/LCD.DB14: U14.7 (A5); also elsewhere on the board
/display/LCD.DB15: U14.8 (A6); also elsewhere on the board
/display/LCD.DC: U12.6 (A4); also elsewhere on the board
/display/LCD.RD: U12.8 (A6); also elsewhere on the board
/display/LCD.TE: U12.4 (A2); also elsewhere on the board
/display/LCD.WR: U12.7 (A5); also elsewhere on the board
/display/LCD.nCS: U12.5 (A3); also elsewhere on the board
/display/LCD.nRST: U14.9 (A7); also elsewhere on the board
/display/LEDK1: J12.2, U11.8 (LED1)
/display/LEDK2: J12.3, U11.7 (LED2)
/display/LEDK3: J12.4, U11.6 (LED3)
/display/LEDK4: J12.5, U11.5 (LED4)
/display/RD: J12.35, U12.13 (B6)
/display/TE: J12.39, U12.17 (B2)
/display/WR: J12.36, U12.14 (B5)
/display/nCS: J12.38, U12.16 (B3)
/display/nRST: J12.10, U14.12 (B7)
/microcontroller/BACKLIGHT_EN: U11.2 (EN); also elsewhere on the board
GND: C20.2, J12.6, J12.9, J12.11, J12.12, J12.13, J12.14, J12.15, J12.16, J12.34, J12.43, J12.48, J12.49, J12.50, U11.1 (PGND), U11.4 (AGND), U11.9 (EP), U12.10 (GND), U12.11 (nOE), U13.10 (GND), U13.11 (nOE), U14.10 (GND), U14.11 (nOE); also elsewhere on the board

Notes on the sheet:
VDDI
DB10
RESET
DB0
DB13
LEDK4
IM2
DB4
GND
DB5
LEDK3
IM1
VCI
XL(X-)/INT
DB7
D/CX(SCL)
DB17
LEDK1
IM0
SDA
DB14
DB11
DB3
LEDK2
DB9
YD(Y+)/SDA
DB12
DB15
CSX
XR(X+)/SCL
HSYNC
LEDA
DB8
YU(Y-)/RESET
WRX(D/CX)
VSYNC
IM3
DB16
DB2
DB1
DOTCLK
DB6

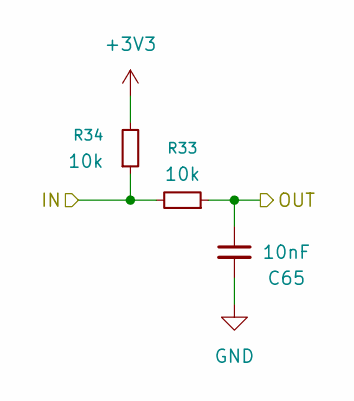
[picture p7: schematic debounce.kicad_sch]

Parts:
C65: 10nF; C_0402_1005Metric; Voltage 50V; LCSC C15195
R33, R34: 10k; R_0402_1005Metric; LCSC C25744

Connections:
+3V3: R34.2; also elsewhere on the board
/Codec/Debounce1/IN: R33.2, R34.1; also elsewhere on the board
/Codec/L_OUT_DETECT: C65.1, R33.1; also elsewhere on the board
GND: C65.2; also elsewhere on the board

Parts of its further copies:
C66, C67, C68, C69, C70, C71, C72, C73, C74, C75: 10nF; C_0402_1005Metric; Voltage 50V; LCSC C15195
R35, R36, R37, R38, R39, R40, R41, R42, R43, R44, R45, R46, R47, R48, R49, R50, R51, R52, R53, R54: 10k; R_0402_1005Metric; LCSC C25744

Connections of its further copies:
+3V3: R35.2, R37.2, R39.2, R41.2, R43.2, R45.2, R47.2, R49.2, R51.2, R53.2; also elsewhere on the board
/Codec/Debounce2/IN: R35.1, R36.2; also elsewhere on the board
/Codec/Debounce3/IN: R37.1, R38.2; also elsewhere on the board
/Codec/IN_DETECT: C67.1, R38.1; also elsewhere on the board
/Codec/R_OUT_DETECT: C66.1, R36.1; also elsewhere on the board
/Input/Debounce1/IN: R39.1, R40.2; also elsewhere on the board
/Input/Debounce2/IN: R41.1, R42.2; also elsewhere on the board
/Input/Debounce3/IN: R43.1, R44.2; also elsewhere on the board
/Input/Debounce4/IN: R45.1, R46.2; also elsewhere on the board
/Input/Debounce5/IN: R47.1, R48.2; also elsewhere on the board
/Input/Debounce6/IN: R49.1, R50.2; also elsewhere on the board
/Input/Debounce7/IN: R51.1, R52.2; also elsewhere on the board
/Input/Debounce8/IN: R53.1, R54.2; also elsewhere on the board
/Input/INPUT.A: C68.1, R40.1; also elsewhere on the board
/Input/INPUT.B: C69.1, R42.1; also elsewhere on the board
/Input/INPUT.L: C74.1, R52.1; also elsewhere on the board
/Input/INPUT.R: C75.1, R54.1; also elsewhere on the board
/Input/INPUT.SELECT: C73.1, R50.1; also elsewhere on the board
/Input/INPUT.START: C72.1, R48.1; also elsewhere on the board
/Input/INPUT.X: C70.1, R44.1; also elsewhere on the board
/Input/INPUT.Y: C71.1, R46.1; also elsewhere on the board
GND: C66.2, C67.2, C68.2, C69.2, C70.2, C71.2, C72.2, C73.2, C74.2, C75.2; also elsewhere on the board
