benthacher/pedal/pedal.kicad_pcb

## KiCad design pedal.kicad_pcb (continued)

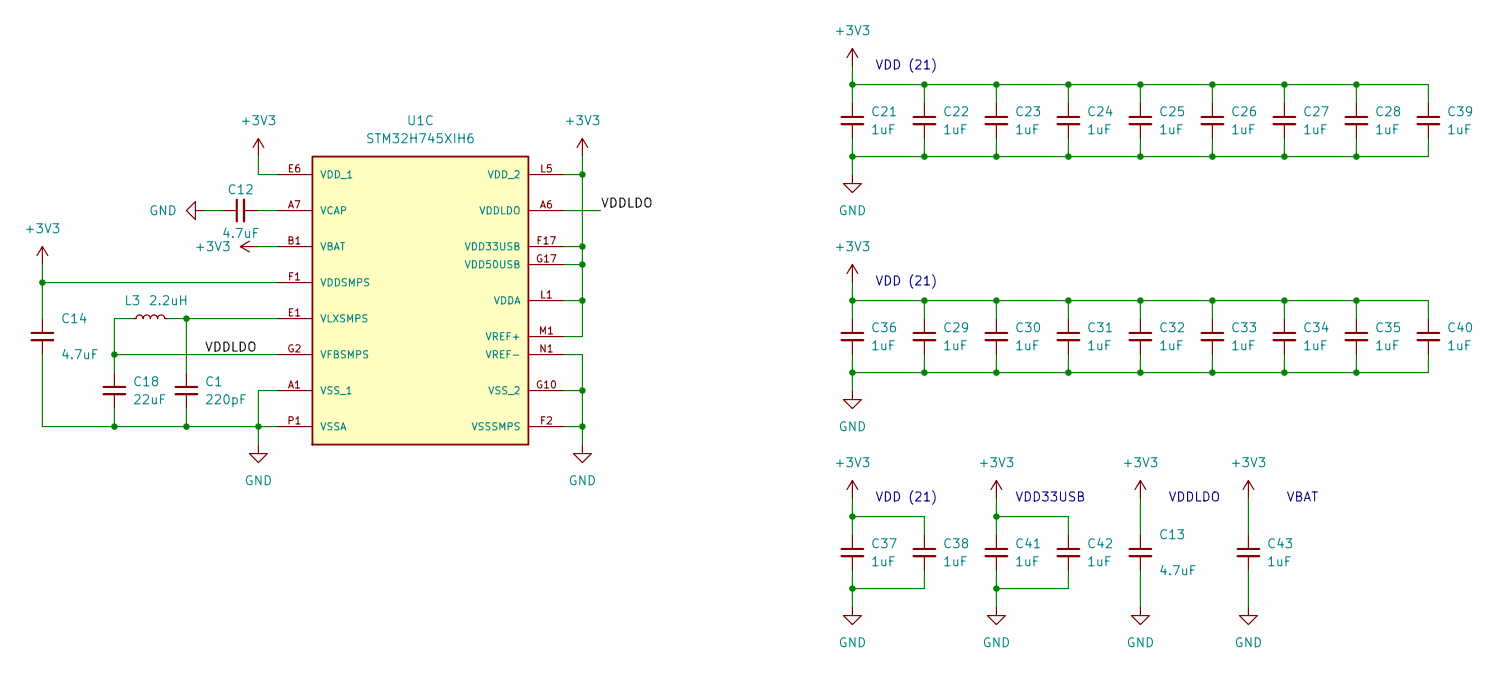
[picture p8: schematic mcu_power.kicad_sch]

Parts:
C1: 220pF; C_0402_1005Metric; Voltage 50V; LCSC C1530
C12, C13, C14: 4.7uF; C_0402_1005Metric; LCSC C23733
C18: 22uF; C_0805_2012Metric; Voltage 25V; LCSC C45783
C21, C22, C23, C24, C25, C26, C27, C28, C29, C30, C31, C32, C33, C34, C35, C36, C37, C38, C39, C40, C41, C42, C43: 1uF; C_0402_1005Metric; voltage 25; LCSC C52923
L3: 2.2uH; L_0805_2012Metric; LCSC C49435080
U1: STM32H745XIH6; BGA265C80P17X17_1400X1400X120; PARTREV 3; LCSC C1338373

Connections:
+3V3: C13.1, C14.1, C21.1, C22.1, C23.1, C24.1, C25.1, C26.1, C27.1, C28.1, C29.1, C30.1, C31.1, C32.1, C33.1, C34.1, C35.1, C36.1, C37.1, C38.1, C39.1, C40.1, C41.1, C42.1, C43.1, U1.B1 (VBAT), U1.E6 (VDD_1), U1.E9 (VDD_1), U1.E11 (VDD_1), U1.F1 (VDDSMPS), U1.F5 (VDD_1), U1.F17 (VDD33USB), U1.G5 (VDD_1), U1.G13 (VDD_1), U1.G17 (VDD50USB), U1.H5 (VDD_1), U1.H13 (VDD_1), U1.J13 (VDD_1), U1.K5 (VDD_1), U1.K13 (VDD_1), U1.L1 (VDDA), U1.L5 (VDD_2), U1.L13 (VDD_2), U1.M1 (VREF+), U1.M5 (VDD_2), U1.M13 (VDD_2), U1.N7 (VDD_2), U1.N8 (VDD_2), U1.N10 (VDD_2), U1.N11 (VDD_2), U1.N12 (VDD_2), U1.P17 (VDD_2); also elsewhere on the board
GND: C1.2, C12.1, C13.2, C14.2, C18.2, C21.2, C22.2, C23.2, C24.2, C25.2, C26.2, C27.2, C28.2, C29.2, C30.2, C31.2, C32.2, C33.2, C34.2, C35.2, C36.2, C37.2, C38.2, C39.2, C40.2, C41.2, C42.2, C43.2, U1.A1 (VSS_1), U1.A17 (VSS_1), U1.B2 (VSS_1), U1.B6 (VSS_1), U1.C10 (VSS_1), U1.C13 (VSS_1), U1.C16 (VSS_1), U1.F2 (VSSSMPS), U1.G7 (VSS_1), U1.G8 (VSS_1), U1.G9 (VSS_1), U1.G10 (VSS_2), U1.G11 (VSS_2), U1.G16 (VSS_1), U1.H7 (VSS_2), U1.H8 (VSS_2), U1.H9 (VSS_2), U1.H10 (VSS_2), U1.H11 (VSS_2), U1.J3 (VSS_1), U1.J7 (VSS_2), U1.J8 (VSS_2), U1.J9 (VSS_2), U1.J10 (VSS_2), U1.J11 (VSS_2), U1.J16 (VSS_1), U1.J17 (VSS_1), U1.K7 (VSS_2), U1.K8 (VSS_2), U1.K9 (VSS_2), U1.K10 (VSS_2), U1.K11 (VSS_2), U1.K15 (VSS_1), U1.L7 (VSS_2), U1.L8 (VSS_2), U1.L9 (VSS_2), U1.L10 (VSS_2), U1.L11 (VSS_2), U1.L15 (VSS_1), U1.M15 (VSS_1), U1.N1 (VREF-), U1.N16 (VSS_1), U1.P1 (VSSA), U1.R4 (VSS_1), U1.R8 (VSS_1), U1.T12 (VSS_1), U1.U1 (VSS_1), U1.U17 (VSS_1); also elsewhere on the board
unnamed: C1.1, L3.2, U1.E1 (VLXSMPS)
VCAP: C12.2, U1.A7 (VCAP), U1.D17 (VCAP), U1.U11 (VCAP)
VDDLDO: C18.1, L3.1, U1.A6 (VDDLDO), U1.C17 (VDDLDO), U1.G2 (VFBSMPS), U1.U12 (VDDLDO)

Notes on the sheet:
VDD33USB
VDD (21)
VDDLDO
VBAT

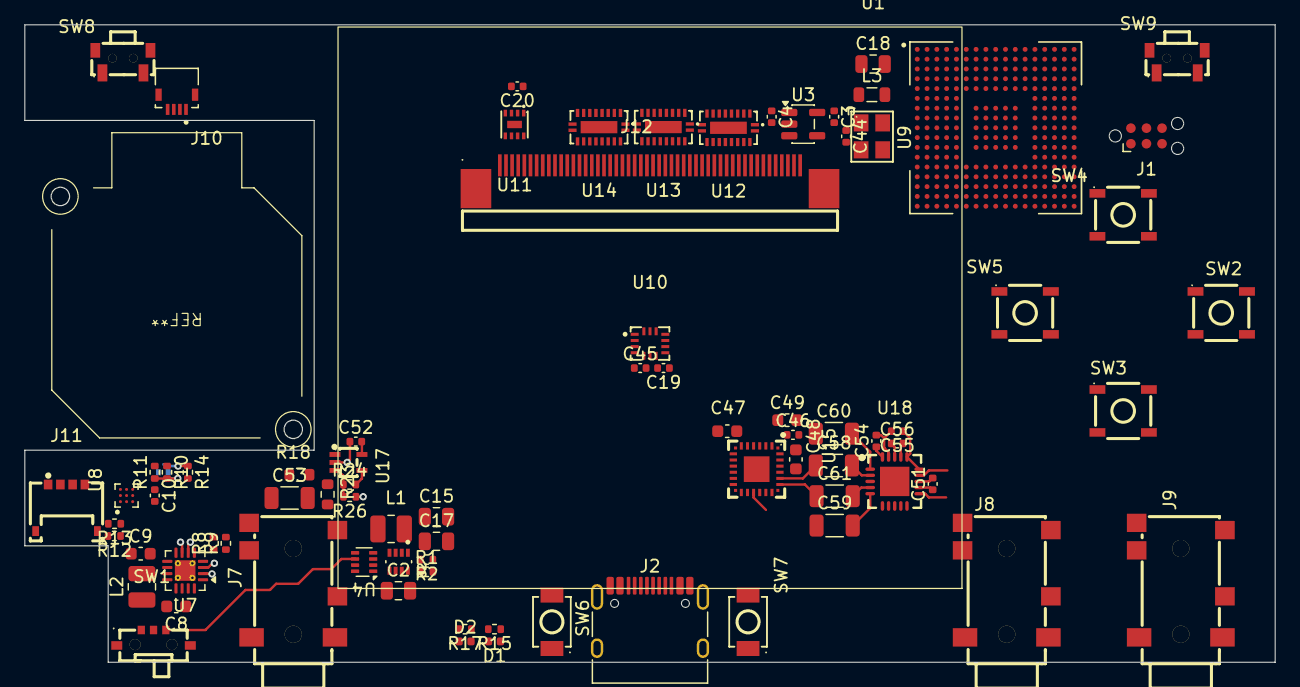
[picture p9: board pedal.kicad_pcb from above]

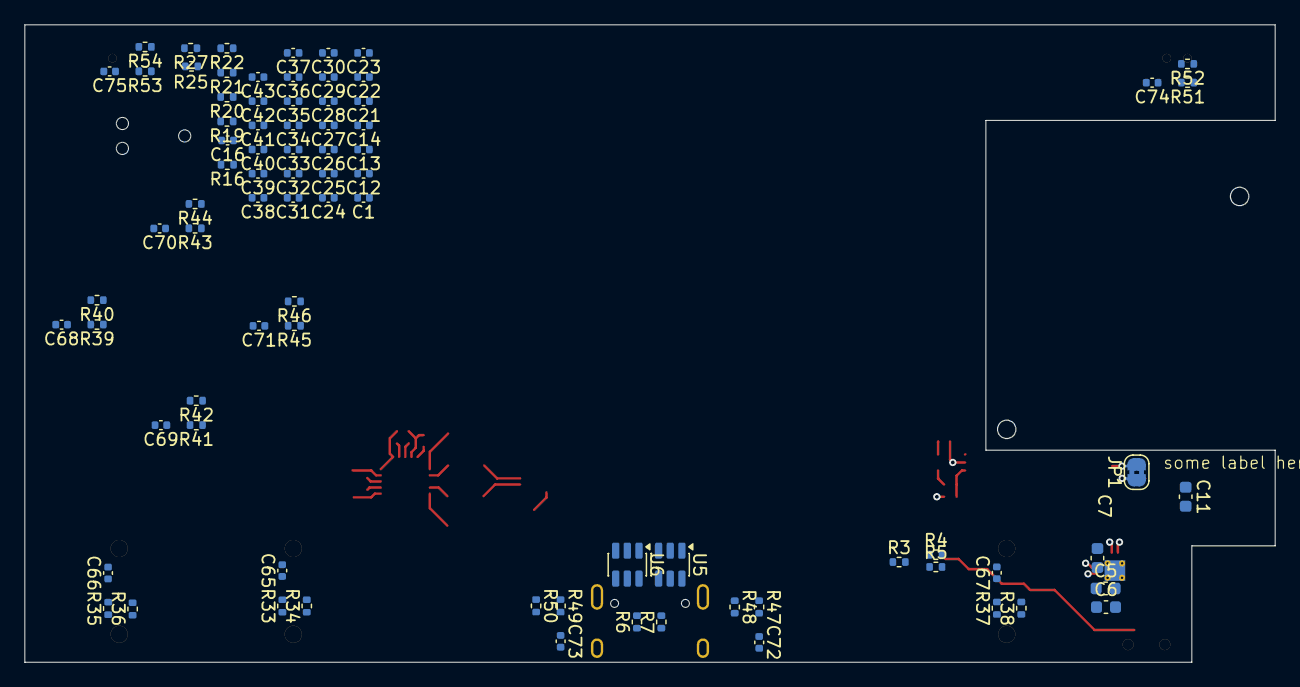
[picture p10: board pedal.kicad_pcb from below]

Board: 4 copper layers, 102.0 x 52.0 mm, 159 parts (80 on the bottom side), 156 nets.
