benthacher/pedal/pedal-cubemx/pedal-cubemx.ioc

Mcu.UserName=STM32H745XIHx
PA11.Signal=USB_OTG_FS_DM
PA12.Signal=USB_OTG_FS_DP
PA3.Signal=ADCx_INP15
PA4.Signal=ADCx_INP18
PA5.GPIO_Label=LED
PA5.Signal=GPIO_Output
PA8.Signal=S_TIM1_CH1
PB5.Signal=SPI1_MOSI
PB6.Signal=I2C1_SCL
PB7.Signal=I2C1_SDA
PC10.Signal=UART4_TX
PC11.Signal=UART4_RX
PC9.Signal=I2C3_SDA
PD0.Signal=FMC_D2_DA2
PD1.Signal=FMC_D3_DA3
PD10.Signal=FMC_D15_DA15
PD14.Signal=FMC_D0_DA0
PD15.Signal=FMC_D1_DA1
PD4.Signal=FMC_NOE
PD5.Signal=FMC_NWE
PD6.Signal=SAI1_SD_A
PD7.Signal=FMC_NE1
PD8.Signal=FMC_D13_DA13
PD9.Signal=FMC_D14_DA14
PE0.Signal=LPTIM1_ETR
PE10.Signal=FMC_D7_DA7
PE11.Signal=FMC_D8_DA8
PE12.Signal=FMC_D9_DA9
PE13.Signal=FMC_D10_DA10
PE14.Signal=FMC_D11_DA11
PE15.Signal=FMC_D12_DA12
PE3.Signal=SAI1_SD_B
PE4.Signal=SAI1_FS_A
PE5.Signal=SAI1_SCK_A
PE7.Signal=FMC_D4_DA4
PE8.Signal=FMC_D5_DA5
PE9.Signal=FMC_D6_DA6
PF1.Signal=I2C2_SCL
PF4.Signal=FMC_A4
PG10.Signal=SPI1_NSS
PG11.Signal=SPI1_SCK
PG9.Signal=SPI1_MISO
PH5.Signal=I2C2_SDA
PH7.Signal=I2C3_SCL
PI0.Signal=GPIO_Output
PI1.Signal=GPIO_Output
PI2.Signal=GPIO_Output
PI3.Signal=GPIO_Output
PI4.Signal=GPIO_Output
PI5.Signal=GPIO_Output
PJ1.Signal=GPXTI1
PJ10.Signal=GPXTI10
PJ11.Signal=GPXTI11
PJ12.Signal=GPXTI12
PJ2.Signal=GPXTI2
PJ3.Signal=GPXTI3
PJ4.Signal=GPXTI4
PJ5.Signal=GPXTI5
PJ6.Signal=GPXTI6
PJ7.Signal=GPXTI7
PJ8.Signal=GPXTI8
PJ9.Signal=GPXTI9
