benthacher/pedal/(commit log)

2026-04-25 Added microcontroller subsheet, gitignore updates
    [pedal.kicad_sch]
2026-04-25 Added microcontroller and custom symbol library
    [STM32H745XIH6.step, microcontroller.kicad_sch, pedal.kicad_pcb, pedal.kicad_sch]
2026-06-05 Power path (#1)
    * add power path sheet
    * Added TPS631000
    * add-symbol.py now removes symbol files
    * fixed microcontroller footprint
    * buck boost regulator schematic done
    * added LDO for LCD rail
    * add tps2121 power mux component
    * wip
    * saved everything
    * remove tps2121
    * fix removing merged library files
    * random silly commit
    * add type c receptacle
    * add esd protection to usb port
    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
    [STM32H745XIH6.step, display.kicad_sch, microcontroller.kicad_sch, pedal.kicad_pcb, pedal.kicad_sch, power_path.kicad_sch]
2026-06-12 MCU (#2)
    * add pedal cubemx file
    * add microcontroller decoupling
    * add decoupling caps
    * fix footprints and add smps
    * add user led
    * add usb
    * add debug pins
    * add fmc pins, stomp uart, fuel gauge i2c
    * update ioc
    * add a bunch of peripherals
    * add all external signals
    * add no connects
    * add oscillator
    [mcu_power.kicad_sch, microcontroller.kicad_sch, pedal.kicad_pcb, power_path.kicad_sch]
2026-06-16 IMU (#3)
    * add imu sheet and library
    * routing between sheets
    [imu.kicad_sch, microcontroller.kicad_sch, pedal.kicad_pcb, pedal.kicad_sch, power_path.kicad_sch]
2026-07-17 Display (#4)
    * add lcd backlight driver, hierarchical signals to display page
    * update ioc with backlight signals
    * Add FPC library
    * Add logic level shifters
    [display.kicad_sch, imu.kicad_sch, microcontroller.kicad_sch, pedal.kicad_pcb, pedal.kicad_sch]
2026-10-01 Codec (#5)
    * Add codec subsheet
    * Add codec ic
    * Add unity gain preamp
    * Finalize input buffer and filtering
    * Add TPA6130A2 DirectDrive output amp
    * Add in/out jacks, remove AC cap at codec input
    [codec.kicad_sch, display.kicad_sch, imu.kicad_sch, mcu_power.kicad_sch, microcontroller.kicad_sch, pedal.kicad_pcb, pedal.kicad_sch, power_path.kicad_sch]
2026-10-02 Input (#6)
    * Add input subsheet
    * Add debounce subsheet
    * Add ultra thin buttons for ABXY
    * Add start and select buttons
    * Add L/R buttons
    * Add joystick connector
    [codec.kicad_sch, debounce.kicad_sch, input.kicad_sch, pedal.kicad_pcb, pedal.kicad_sch]
2026-10-02 moved crap
    [pedal.kicad_pcb]
2026-10-10 Move everything onto the board
